reuf/EAA690_RFID/README.md

EAA690_RFID
===========

RFID door lock for EAA690 hangar door

Brian was here
