reuf/EAA690_RFID/EagleCAD/EAA690_RFID.pdf

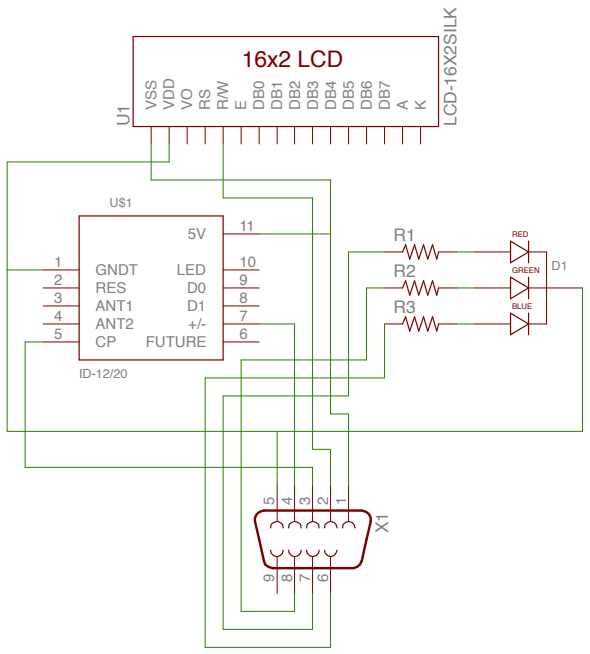
[picture p7: figure]
LCD-16X2SILK; GNDT 1 RES 2 ANT1 3 ANT2 4; FUTURE; 9 LED; VSS; VDD; 16x2 LCD; RED; GREEN; BLUE

5/28/14 6:44 PM /Users/bmichael/git/EAA690_RFID/EAA690_RFID.sch (Sheet: 1/1)
