reuf/EAA690_RFID/EagleCAD/EAA690_RFID_Controller.png

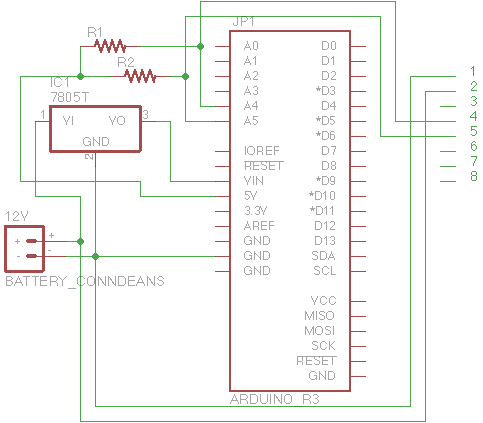
EagleCAD/EAA690_RFID_Controller.png
