reuf/EAA690_RFID/EagleCAD/EAA690_RFID_Door.png

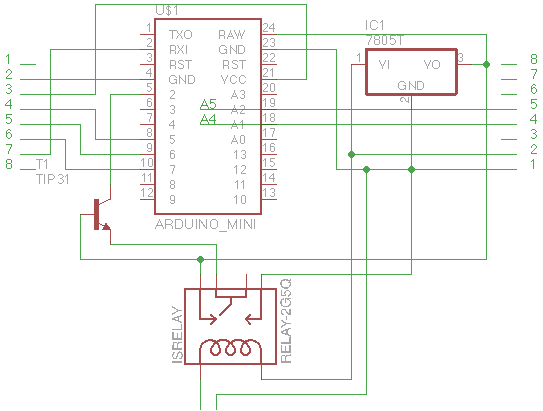
EagleCAD/EAA690_RFID_Door.png
