reuf/EAA690_RFID/EagleCAD/EAA690_RFID_Outside.png

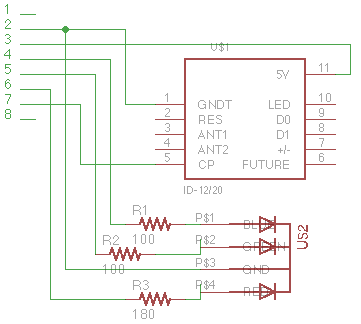
EagleCAD/EAA690_RFID_Outside.png
