reuf/EAA690_RFID/EagleCAD/EAA690_RFID_Out_Sch.pdf

# 16x2 LCD

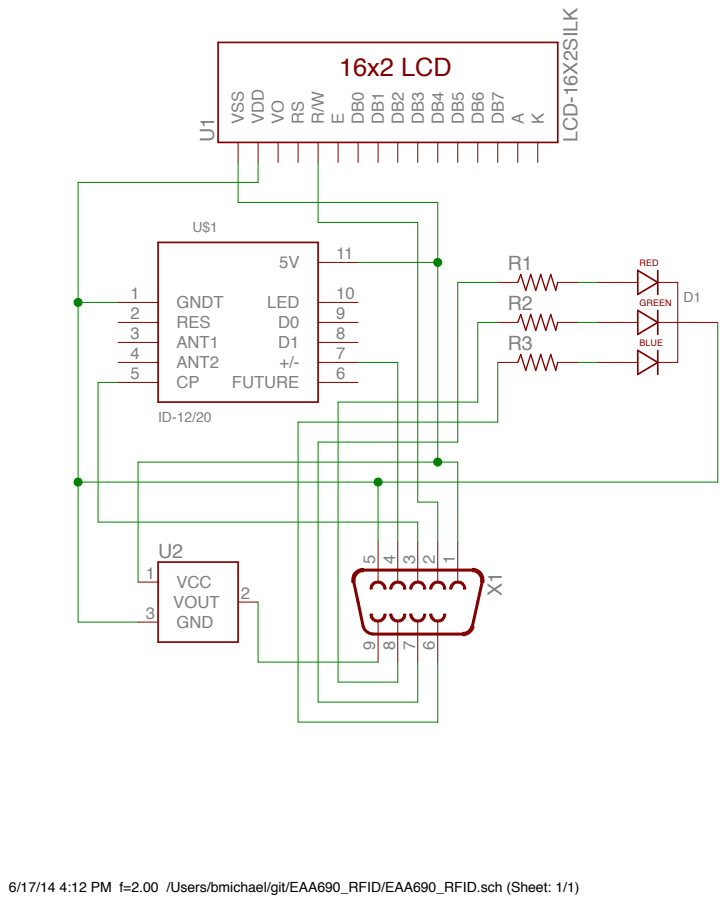
[picture p11: page 1]
LCD-16X2SILK; GNDT 1 RES 2 ANT1 3 ANT2 4; FUTURE; 9 LED; VSS; VDD; VCC 1; GND 3; VOUT; RED; GREEN; BLUE

6/17/14 4:12 PM f=2.00 /Users/bmichael/git/EAA690_RFID/EAA690_RFID.sch (Sheet: 1/1)
