reuf/EAA690_RFID/EAA690_RFID_v2.sch

## EAGLE design EAA690_RFID_v2.sch (2015-06-12)

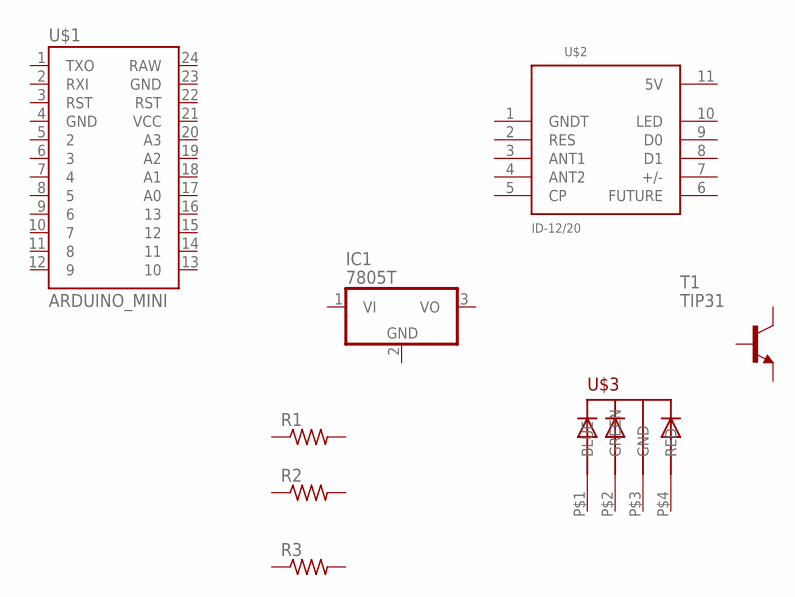
[picture p12: schematic EAA690_RFID_v2.sch]

Parts:
IC1: 7805T; TO220H
R1, R2, R3: R-US_0617/22; 0617/22
T1: TIP31; TO220
U$1: ARDUINO_MINI
U$2: ID-12/20; ID-12
U$3: 5MMRGBLED; LED5MMRGB
