reuf/EAA690_RFID/EagleCAD/EAA690_RFID_Controller.sch

## EAGLE design EagleCAD/EAA690_RFID_Controller.sch (2015-06-14)

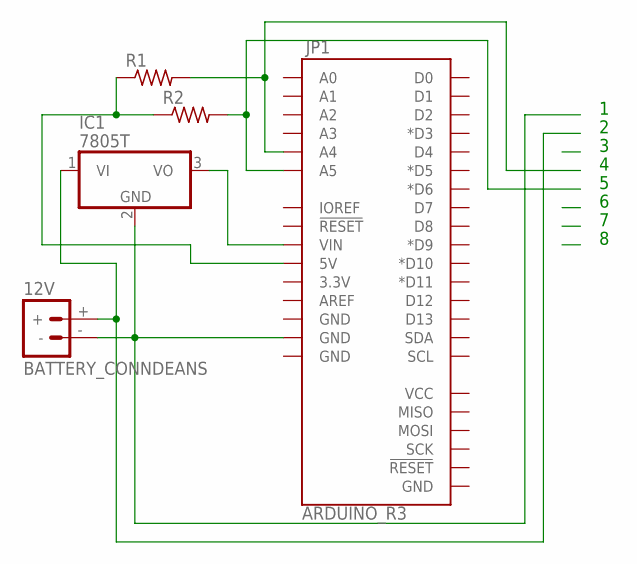
[picture p13: schematic EAA690_RFID_Controller.sch]

Parts:
12V: BATTERY_CONNDEANS; DEANS
IC1: 7805T; TO220H
JP1: ARDUINO_R3
R1, R2: R-US_0204/5; 0204/5

Connections:
unnamed: 12V.-, IC1.2 (GND), JP1.GND@3 (GND)
unnamed: 12V.+, IC1.1 (VI)
unnamed: JP1.5V, R1.1, R2.1
unnamed: JP1.A5, R2.2
unnamed: JP1.A4, R1.2
unnamed: IC1.3 (VO), JP1.VIN
