reuf/EAA690_RFID/EagleCAD/EAA690_RFID_Door.sch

## EAGLE design EagleCAD/EAA690_RFID_Door.sch (2015-06-14)

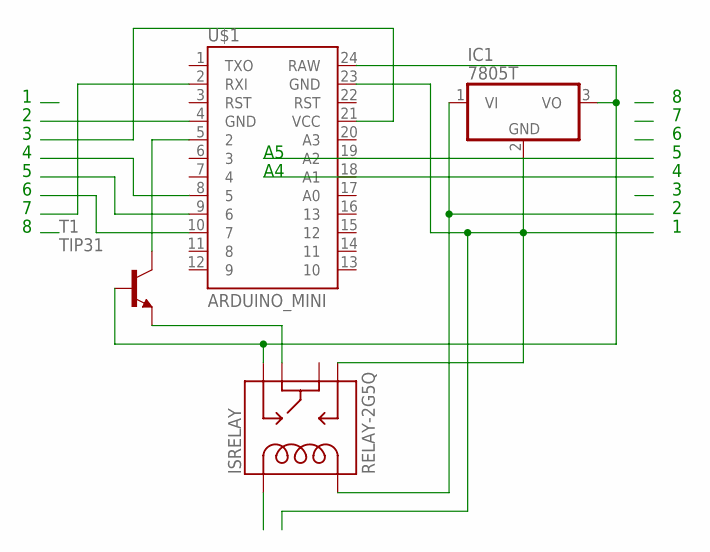
[picture p14: schematic EAA690_RFID_Door.sch]

Parts:
IC1: 7805T; TO220H
ISRELAY: RELAY-2G5Q; RELAY-G5V
T1: TIP31; TO220
U$1: ARDUINO_MINI

Connections:
unnamed: T1.2 (C), U$1.5 (2)
unnamed: IC1.3 (VO), ISRELAY.1, T1.1 (B), U$1.24 (RAW)
unnamed: IC1.2 (GND), ISRELAY.10, U$1.23 (GND)
unnamed: ISRELAY.5, T1.3 (E)
unnamed: IC1.1 (VI), ISRELAY.9
