reuf/EAA690_RFID/EagleCAD/EAA690_RFID_In.sch

## EAGLE design EagleCAD/EAA690_RFID_In.sch (2014-06-19)

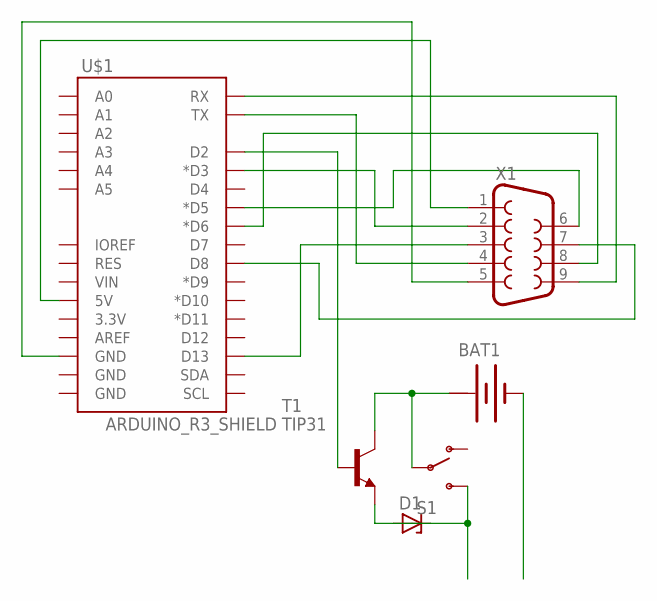
[picture p15: schematic EAA690_RFID_In.sch]

Parts:
BAT1: BATTERY
D1: ZENER-DIODESOD64-12; SOD64Z12
S1: SWITCH-SPDTPTH; SWITCH-SPDT
T1: TIP31; TO220
U$1: ARDUINO_R3_SHIELD; UNO_R3_SHIELD
X1: DB9FEMALE; DB9

Connections:
unnamed: U$1.RX, X1.9
unnamed: U$1.TX, X1.4
unnamed: T1.1 (B), U$1.D2
unnamed: U$1.D3 (*D3), X1.2
unnamed: U$1.D5 (*D5), X1.6
unnamed: U$1.D6 (*D6), X1.8
unnamed: U$1.D8, X1.7
unnamed: U$1.5V, X1.1
unnamed: U$1.GND@2 (GND), X1.5
unnamed: U$1.D13, X1.3
unnamed: D1.A, D1.C, S1.3 (S), T1.3 (E)
unnamed: BAT1.+, S1.2, T1.2 (C)
