reuf/EAA690_RFID/EagleCAD/EAA690_RFID_Outside.sch

## EAGLE design EagleCAD/EAA690_RFID_Outside.sch (2015-06-14)

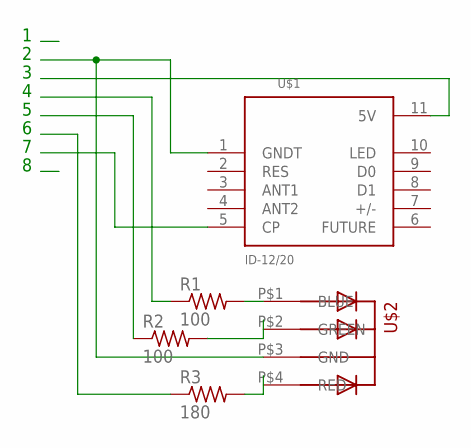
[picture p16: schematic EAA690_RFID_Outside.sch]

Parts:
R1, R2: 100; 0204/5
R3: 180; 0204/5
U$1: ID-12/20; ID-12
U$2: 5MMRGBLED; LED5MMRGB

Connections:
unnamed: U$1.1 (GNDT), U$2.P$3 (GND)
unnamed: R1.2, U$2.P$1 (BLUE)
