reuf/EAA690_RFID/(commit log)

2014-05-28 Adding temperature sensor and routines
2014-05-28 Eagle CAD sketch
    [EAA690_RFID.sch]
2014-06-17 Adding TMP36 to schematic
    [EAA690_RFID.sch]
2014-06-17 Adding inside diagram and WiFi shield schematic
    [EAA690_RFID_In.sch]
2014-06-17 Minor changes
    [EAA690_RFID_In.sch]
2014-06-19 Updating Green PIN
2015-03-17 Using bare I2C
2015-03-30 Server side stuff
    [database.csv]
2015-06-12 Python updates and new version of Eagle CAD drawing
    [EAA690_RFID_v2.sch]
2015-06-14 Eagle CAD Schematics
    [EAA690_RFID_Controller.sch, EAA690_RFID_Door.sch, EAA690_RFID_Outside.sch]
2015-06-14 Moving CAD files and adding presentation
    [EAA690_RFID.sch, EAA690_RFID_Controller.sch, EAA690_RFID_Door.sch, EAA690_RFID_In.sch, EAA690_RFID_Outside.sch, EAA690_RFID_v2.sch]
